BRivsC/ELO301-G8/Diseño/Cotización PCB.xlsx

Características impresión
Tamaño | 82,50x70,00 mm
# de capas | 2
Sin ensamblado
Fabricante | Por 100 Us | Por 1 Un | Transporte | Empresa transporte | Tiempo de envío | Total
PCBWay | $91.02 | $0.9102 | $79.61 | FedEx IP | 4-7 días hábiles | $170.63
JLCPCB | $34.80 | $0.3480 | $88.95 | DHL Express Economy | 5-7 días hábiles | $123.75
NextPCB | $58.92 | $0.5892 | $80.32 | FedEx | 3-5 días hábiles | $139.24
