BRivsC/ELO301-G8/WIFI_Shield_Rev4/WIFI_Shield_Rev4/SCHEMATIC_R1.brd

## EAGLE design WIFI_Shield_Rev4/WIFI_Shield_Rev4/SCHEMATIC_R1.brd (2023-12-03)

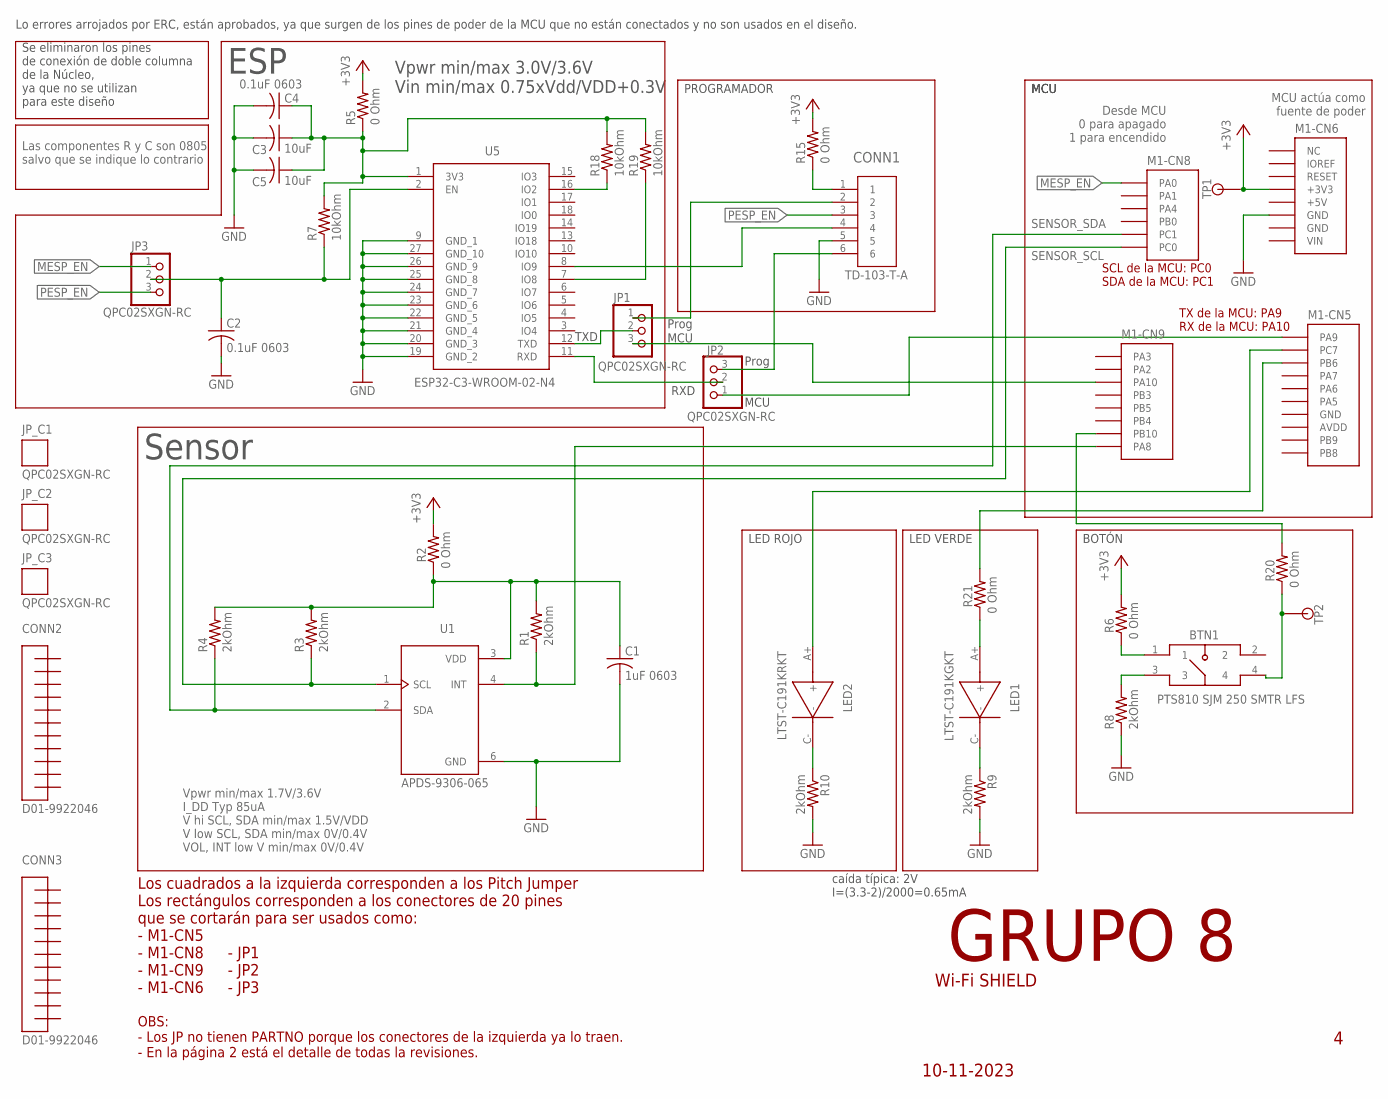
[picture p4: schematic SCHEMATIC_R1.sch, sheet 1]

Parts:
BTN1: PTS810 SJM 250 SMTR LFS; PTS810; PARTNO PTS810 SJM 250 SMTR LFS
C1: 1uF 0603; C0603; PARTNO GCM188R71C105KA64D
C2, C4: 0.1uF 0603; C0603; PARTNO GRM188R72A104KA35D
C3, C5: 10uF; C0805; PARTNO GRM21BR71A106KA73L
CONN1: TD-103-T-A; CON6_2X3_TU_HTS_SAI; PARTNO TD-103-T-A
JP1, JP2, JP3: QPC02SXGN-RC; 1X03
JP_C1, JP_C2, JP_C3: QPC02SXGN-RC; PLACEHOLDER; PARTNO QPC02SXGN-RC
LED1: LTST-C191KGKT; 0603; PARTNO LTST-C191KGKT
LED2: LTST-C191KRKT; 0603; PARTNO LTST-C191KRKT
M1: NUCLEO-L452RE; NUCLEO-64; PARTNO NUCLEO-L452RE
R1, R3, R4, R8, R9, R10: 2kOhm; M0805; PARTNO RMCF0805FT2K00
R2, R5, R6, R15, R20, R21: 0 Ohm; M0805; PARTNO RMCF0805ZT0R00
R7, R18, R19: 10kOhm; R0805; PARTNO RMCF0805JT10K0
TP1, TP2: TESTPOINT
U1: APDS-9306-065; SON65P200X200X75-6N; PARTNO APDS-9306-065
U5: ESP32-C3-WROOM-02-N4; ESP32C3WROOM02N4; PARTNO ESP32-C3-WROOM-02-N4

Connections:
+3V3: M1.CN6-4 (+3V3), R2.2, R5.2, R6.2, R15.2, TP1.TP
+5V: M1.CN6-5 (+5V)
AVDD: M1.CN5-8 (AVDD)
GND: C1.2, C2.2, C3.2, C4.2, C5.2, CONN1.5, M1.CN5-7 (GND), M1.CN6-6 (GND), M1.CN6-7 (GND), R8.1, R9.2, R10.2, U1.6 (GND), U5.9 (GND_1), U5.19 (GND_2), U5.20 (GND_3), U5.21 (GND_4), U5.22 (GND_5), U5.23 (GND_6), U5.24 (GND_7), U5.25 (GND_8), U5.26 (GND_9), U5.27 (GND_10)
IOREF: M1.CN6-2 (IOREF)
MESP_EN: JP3.1, M1.CN8-1 (PA0)
unnamed: M1.CN9-7 (PB10), R20.2
unnamed: C1.1, R1.2, R2.1, R3.2, R4.2, U1.3 (VDD)
unnamed: M1.CN9-8 (PA8), R1.1, U1.4 (INT)
unnamed: LED2.A+ (+), M1.CN5-2 (PC7)
unnamed: BTN1.3, R8.2
unnamed: R18.1, U5.16 (IO2)
unnamed: BTN1.1, R6.1
unnamed: JP1.3, M1.CN9-3 (PA10)
unnamed: JP2.1, M1.CN5-1 (PA9)
unnamed: BTN1.4, R20.1, TP2.TP
unnamed: M1.CN5-3 (PB6), R21.2
unnamed: LED2.C- (-), R10.1
unnamed: LED1.C- (-), R9.1
unnamed: JP2.2, U5.11 (RXD)
unnamed: CONN1.2, JP1.1
unnamed: CONN1.6, JP2.3
unnamed: CONN1.4, U5.8 (IO9)
unnamed: CONN1.1, R15.1
unnamed: R19.1, U5.7 (IO8)
unnamed: C2.1, JP3.2, R7.1, U5.2 (EN)
unnamed: C3.1, C4.1, C5.1, R5.1, R7.2, R18.2, R19.2, U5.1 (3V3)
unnamed: LED1.A+ (+), R21.1
unnamed: JP1.2, U5.12 (TXD)
PESP_EN: CONN1.3, JP3.3
SENSOR_SCL: M1.CN8-6 (PC0), R3.1, U1.1 (SCL)
SENSOR_SDA: M1.CN8-5 (PC1), R4.1, U1.2 (SDA)
VIN: M1.CN6-8 (VIN)

Notes on the sheet:
Vpwr min/max 3.0V/3.6V Vin min/max 0.75xVdd/VDD+0.3V
Vpwr min/max 1.7V/3.6V I_DD Typ 85uA V hi SCL, SDA min/max 1.5V/VDD V low SCL, SDA min/max 0V/0.4V VOL, INT low V min/max 0V/0.4V
Las componentes R y C son 0805 salvo que se indique lo contrario
Desde MCU 0 para apagado 1 para encendido
caída típica: 2V I=(3.3-2)/2000=0.65mA
Se eliminaron los pines de conexión de doble columna de la Núcleo, ya que no se utilizan para este diseño
Sensor
LED ROJO
LED VERDE
BOTÓN
MCU
PROGRAMADOR
ESP
MCU actúa como fuente de poder
Lo errores arrojados por ERC, están aprobados, ya que surgen de los pines de poder de la MCU que no están conectados y no son usados en el diseño.
Wi-Fi SHIELD
10-11-2023
GRUPO 8
RXD
Prog
TXD
Los cuadrados a la izquierda corresponden a los Pitch Jumper Los rectángulos corresponden a los conectores de 20 pines que se cortarán para ser usados como: - M1-CN5 - M1-CN8 - M1-CN9 - M1-CN6
OBS: - Los JP no tienen PARTNO porque los conectores de la izquierda ya lo traen. - En la página 2 está el detalle de todas la revisiones.
- JP1 - JP2 - JP3
TX de la MCU: PA9 RX de la MCU: PA10
SCL de la MCU: PC0 SDA de la MCU: PC1

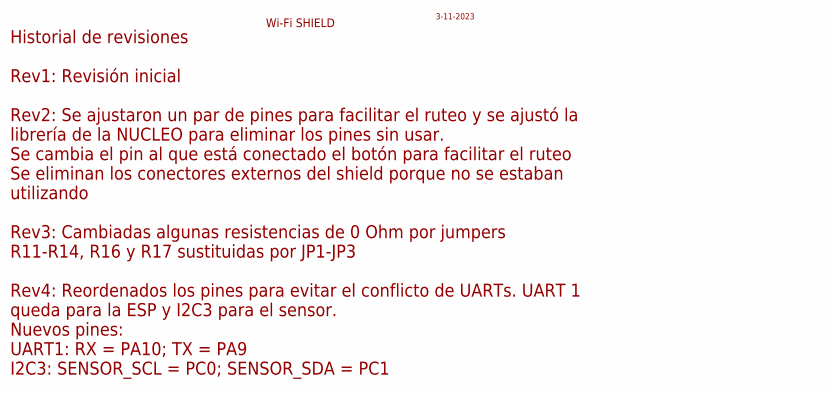
[picture p5: schematic SCHEMATIC_R1.sch, sheet 2]

Notes on the sheet:
Wi-Fi SHIELD
3-11-2023
Historial de revisiones Rev1: Revisión inicial Rev2: Se ajustaron un par de pines para facilitar el ruteo y se ajustó la librería de la NUCLEO para eliminar los pines sin usar. Se cambia el pin al que está conectado el botón para facilitar el ruteo Se eliminan los conectores externos del shield por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

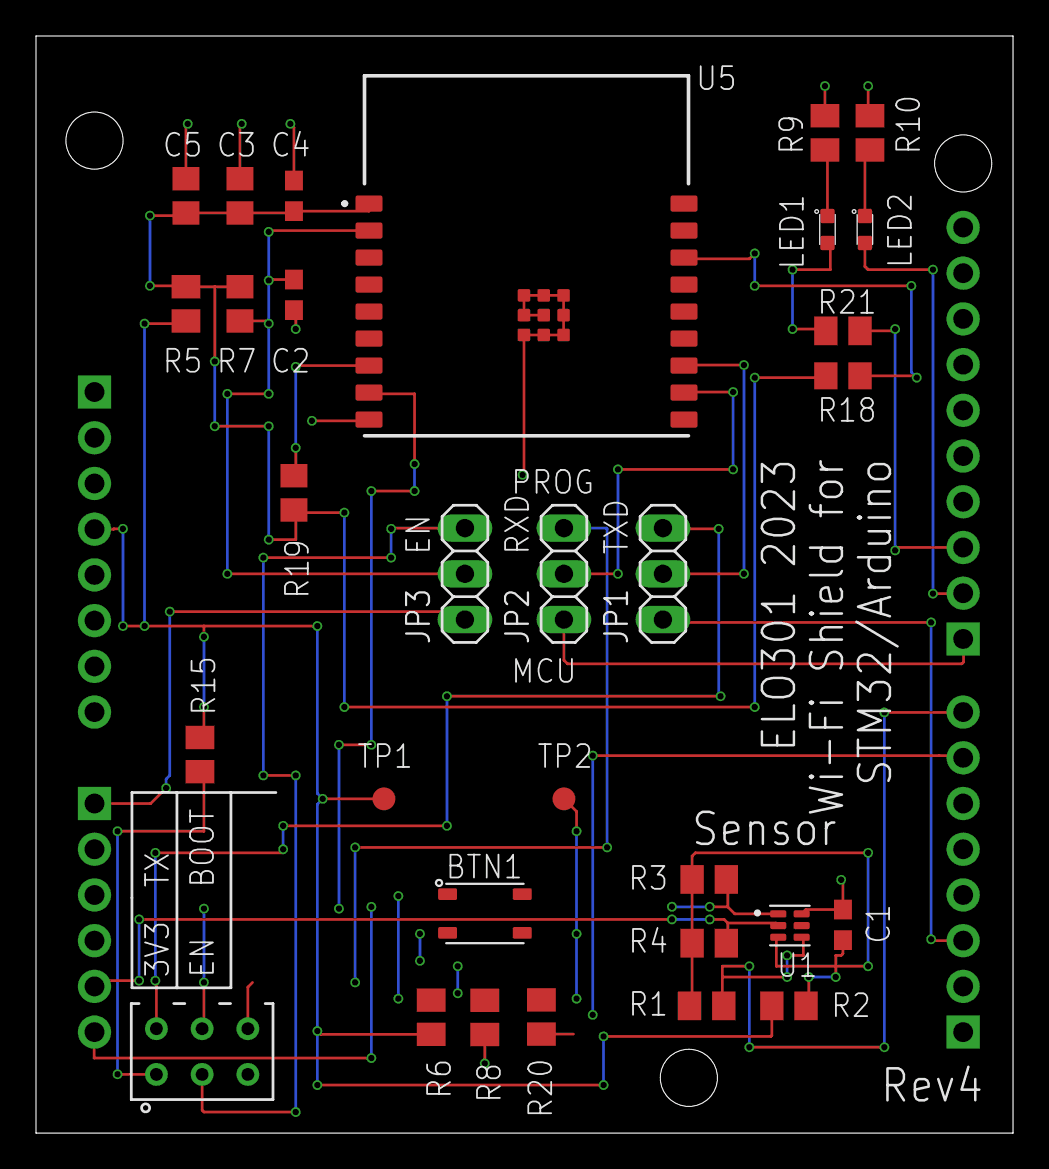
[picture p6: board SCHEMATIC_R1.brd from above]

Board: 2 copper layers, 54.3 x 60.9 mm, 35 parts (0 on the bottom side), 29 nets.
