BRivsC/ELO301-G8/Firmware/FW Wi-Fi Shield Rev1/Core/Src/main.c

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
/* Includes ------------------------------------------------------------------*/
#include "main.h"
#include "i2c.h"
#include "tim.h"
#include "usart.h"
#include "gpio.h"

/* USER CODE BEGIN Includes */
#include "interrupts.h"
#include "at_command.h"
#include "GebraBit_APDS9306.h"
/* USER CODE END Includes */

/* USER CODE BEGIN PTD */
GebraBit_APDS9306 APDS9306_Module;	// struct con los datos del sensor
/* USER CODE END PTD */

/* USER CODE BEGIN PM */
// Mensaje de bienvenida
#define WELCOME_MSG	"ELO301 Wi-Fi Shield\n\rRevisión actual: Rev1\n\r"

#define SENSOR_TEST_EN 0			// Macro para el test del sensor. 1 para testearlo, 0 para el funcionamiento normal
#define SENSOR_TEST_WELCOME_MSG "Modo de prueba del sensor.\n\rPara salir, definir SENSOR_TEST_EN de main.c en 0 y recompilar\n\r"
#define MSG_SIZE 30					// Tamaño del mensaje a enviar por la UART2
#define SENSOR_TEST_DELAY_MS 250	// Delay para mediciones del test
#define TIMEOUT_100MS 100

#define SEND_CLK 0					// 1 para mandar valor del clock en lugar de la medición del sensor
#define CON_TEST 0					// 1 para probar conexión
/* USER CODE END PM */


/* USER CODE BEGIN PV */
enum ESTADO estado=WAIT_ESP;		//Variable que identifica el estado del sistema (FSM).
int BTN=0;							//1 si se resionó el botón, 0 eoc.
enum ESP_ESTADO esp_connect=WAIT;	//resultado de la conexión a internet de la ESP.
enum ESP_ESTADO esp_envio=WAIT; 	//resultado del envío de datos.
volatile char msg;
int disc=0;
int ESP_OK=0;
int ESP_READY=0;
int count=0;
//int timeout=1;
int NI=1;
enum LEDS leds=OFF;					//estado de los leds de estado.
int Q_OK=0;
extern uint8_t rx_buffer;
float luminosidad;					// luminosidad medida
int luminosidad_int;				// luminosidad en entero
/* USER CODE END PV */

void SystemClock_Config(void);
/**
  * @brief  The application entry point.
  * @retval int
  */
int main(void)
{
  /* USER CODE BEGIN 1 */
	//enum ESTADO estado=WAIT_ESP;		//Variable que identifica el estado del sistema (FSM).
	int intentos=0;						//Contador de intentos de conexión.

	uint32_t timeout=0;
	uint32_t DELAY = 2000;
							//1 para ESP lista para trabajar, 0 eoc.
	//int BTN=0;							//1 si se resionó el botón, 0 eoc.
	int reconexion=0;					//1 si se intenta reconexión, 0 eoc.
	chg_led_state(leds);				//al iniciar el sistema se apagan los leds (estado de WAIT_ESP)
	uint32_t time;
	uint8_t text[10];
	memset(text,"\0",10);
	/* USER CODE END 1 */

  /* MCU Configuration--------------------------------------------------------*/

  /* Reset of all peripherals, Initializes the Flash interface and the Systick. */
  HAL_Init();

  /* USER CODE BEGIN Init */
  // Conectarse a ESP


  /* USER CODE END Init */

  /* Configure the system clock */
  SystemClock_Config();

  /* Initialize all configured peripherals */
  MX_GPIO_Init();
  MX_USART2_UART_Init();
  MX_I2C3_Init();
  MX_TIM3_Init();
  MX_USART1_UART_Init();
  /* USER CODE BEGIN 2 */

  char medicion_uart[MSG_SIZE];	// mensaje a mandar por UART
  GB_APDS9306_initialize(&APDS9306_Module);
  GB_APDS9306_Configuration(&APDS9306_Module);

#if SENSOR_TEST_EN
  /* Test del sensor:
   * 	- Leer ID del sensor y printear su ID
   * 	- Tomar mediciones cada cierto tiempo definido por SENSOR_TEST_DELAY_MS y enviarlas por la UART2 como texto
   */
  //char msg[MSG_SIZE];	// mensaje a mandar por UART
  //float luminosidad;	// la variable que extrae la medición de luminosidad
  //int luminosidad_int;	// luminosidad como entero para poder usar sprintf sin reconfigurar el proyecto
  /* Inicializar struct del sensor
   * 	De esto interesa conseguir al miembro PART_ID del struct para identificar el sensor
   */
  GB_APDS9306_initialize(&APDS9306_Module);
  GB_APDS9306_Configuration(&APDS9306_Module);


  // Mensaje de bienvenida
  HAL_UART_Transmit(&huart2, (uint8_t*) SENSOR_TEST_WELCOME_MSG, strlen(SENSOR_TEST_WELCOME_MSG),TIMEOUT_100MS);

  // Obtener ID del sensor y mandarla por UART
  sprintf(msg, "ID: %02X\n\r",APDS9306_Module.PART_ID);
  HAL_UART_Transmit(&huart2, (uint8_t*) msg, strlen(msg), TIMEOUT_100MS);

  /* Loop infinito: Tomar mediciones cada 1 segundo permanentemente
   * 	Cada medición tomada se registra en el miembro LUMINOSITY del struct APDS9306_Module
   * 	Ojo! Mide en float, por lo que puede que sprintf tire error si no se reconfigura el proyecto
   */

  while(1){
	  // Obtener medición
	  GB_APDS9306_Get_Data(&APDS9306_Module);

	  // Cast como INT para evitar reconfigurar MCU porque sprintf tiene mañas con los float
	  luminosidad = APDS9306_Module.LUMINOSITY;	// rescatar luminosidad del struct
      luminosidad_int = (int) luminosidad;


      // Generar mensaje y enviarlo por UART2
      sprintf(msg, ">>Medición: %d\n\r",luminosidad_int);	// Va desde 0 (oscuro) a 873810 (luz solar directa)
      HAL_UART_Transmit_IT(&huart2, (uint8_t*) msg, strlen(msg));
      HAL_Delay(SENSOR_TEST_DELAY_MS);

  }
#endif

  HAL_UART_Transmit(&huart2, (uint8_t*) WELCOME_MSG, strlen(WELCOME_MSG),TIMEOUT_100MS);
  /* USER CODE END 2 */

  /* Infinite loop */
  /* USER CODE BEGIN WHILE */
  HAL_UART_Receive_IT(&huart1, (uint8_t*) &msg, 1);
  resetModule();
  //HAL_UART_Transmit_IT(&huart1, "ATE0\r\n", 6);
  while (1){
	  switch(estado){
	  	  case WAIT_ESP:
	  		//HAL_UART_Transmit(&huart2, "HOLA\r\n", 6, 100);
	  		  if(ESP_OK){
		  		  reconexion=0;
	  			  intentos=0;
	  			  esp_connect=FAIL;

#if CON_TEST
	  			  HAL_UART_Transmit_IT(&huart1, "AT+CWQAP\r\n", 10);
	  			  estado=QUERY_CONEXION;
#else
	  			  setModeToStation();
	  			  HAL_UART_Transmit(&huart2, rx_buffer, sizeof(rx_buffer), TIMEOUT_100MS);
	  			  estado=WAIT_OK_ESP;
	  			  ESP_READY=0;
#endif
	  			  ESP_OK=0;
	  		  }
	  		  else{
	  			  estado=WAIT_ESP;
	  		  }
			  break;
	  	  case QUERY_CONEXION:
	  		  if(Q_OK){
	  			  setModeToStation();
	  			  HAL_UART_Transmit(&huart2, rx_buffer, sizeof(rx_buffer), TIMEOUT_100MS);
	  			  estado=WAIT_OK_ESP;
	  			  Q_OK=0;
	  		  }
	  		  else{
	  			  estado=QUERY_CONEXION;
	  		  }
	  		  ESP_READY=0;
	  		  break;
	  	  case WAIT_OK_ESP:
  			  if(ESP_READY==1){
  				HAL_UART_Transmit(&huart2, rx_buffer, sizeof(rx_buffer), TIMEOUT_100MS);
  				estado=ESTABLECER_CONEXION_WI_FI;
  				ESP_READY=0;
  			  }
  			  else{
  				  estado=WAIT_OK_ESP;
  			  }
  			  break;
	  	  case ESTABLECER_CONEXION_WI_FI:
	  		  estado=ESTABLECER_CONEXION_WI_FI;
	  		  if((intentos<3)&&(esp_connect==FAIL)){		//3 intentos para establecer conexión
	  			  //mandar comando AT para conexión
	  			  setAPcnx();
	  			  intentos+=1;
	  			  if (intentos != 3){
	  				  esp_connect=WAIT;
	  				  estado=ESTABLECER_CONEXION_WI_FI;
	  			  }
	  			  else{
	  				  estado=ESTABLECER_CONEXION_WI_FI;
	  			  }
	  		  }
	  		  else if((esp_connect==OK)&&(reconexion==0)){	//Correcta conexión por primera vez
	  		  	  leds=CONEXION_EXITOSA;
	  			  chg_led_state(leds);
	  			  estado=CONECTADO;
	  		  }
	  		  else if((esp_connect==OK)&&(reconexion==1)){	//Reconexión para volver a intentar el envío de datos
	  			  leds=BUSY;
	  			  chg_led_state(leds);
	  			  esp_envio=WAIT;
	  			  estado=ENVIAR_DATOS;
	  		  }
	  		  else if((esp_connect==FAIL)&&(intentos==3)){	//Falla la conexión, se reinicia la ESP
	  			  ESP_OK=0;
	  			  leds=FALLO_CRITICO;
	  			  chg_led_state(leds);
	  			  timeout=HAL_GetTick();
	  			  estado=FALLO_CONEXION;
	  		  }
	  		  else{
	  			  estado=ESTABLECER_CONEXION_WI_FI;
	  		  }
	  		  break;
	  	  case CONECTADO:
	  		  if(BTN && disc==0){//Hay que recolectar y enviar datos
	  			  leds=BUSY;
	  			  chg_led_state(leds);
	  			  //lee sensor
	  			  GB_APDS9306_Get_Data(&APDS9306_Module);

	  			  esp_envio=WAIT;
	  			  BTN=0;
	  			  estado=ENVIAR_DATOS;
	  		  }
	  		  else if(disc==1){
	  			  disc=0;
	  			  estado=ESTABLECER_CONEXION_WI_FI;
	  		  }
	  		  else{
	  			  estado=CONECTADO;
	  		  }
	  		  break;
	  	  case ENVIAR_DATOS:
#if SEND_CLK
	  		  // Mandar valor actual del CLK
	  		  time=HAL_GetTick();
	  		  memset(text,"\0",10);
	  		  sprintf(text,"%d",time);
	  		  sendSensorData((uint8_t*)text);

#else
	  		  // Mandar medición del sensor
	  		  // Cast como INT para evitar reconfigurar MCU porque sprintf tiene mañas con los float
	  		  luminosidad = APDS9306_Module.LUMINOSITY;	// rescatar luminosidad del struct
	  	      luminosidad_int = (int) luminosidad;
	  	      sprintf(text,"%d",luminosidad_int);
	  	      sprintf(medicion_uart, ">>Medición: %d\n\r",luminosidad_int);	// Va desde 0 (oscuro) a 873810 (luz solar directa)
	  	      HAL_UART_Transmit_IT(&huart2, (uint8_t*) medicion_uart, strlen(medicion_uart));
	  		  sendSensorData((uint8_t*)text);
#endif
	  		  estado=WAIT_ENVIAR_DATOS;
	  		  break;
	  	  case WAIT_ENVIAR_DATOS:
	  		  if(esp_envio==OK){//se enviaron correctamente los datos
	  			  leds=CONEXION_EXITOSA;
	  			  chg_led_state(leds);
	  			  estado=CONECTADO;
	  		  }
	  		  else if(esp_envio==FAIL){//Fallo al enviar datos
	  			  timeout=HAL_GetTick();
	  			  estado=PERDIO_CONEXION;
	  		  }
	  		  else{
	  			  estado=WAIT_ENVIAR_DATOS;
	  		  }
	  		  break;
	  	  case PERDIO_CONEXION:
			leds=FALLO_CRITICO;
	  		chg_led_state(leds);
	  		reconexion=1;
	  		esp_connect=FAIL; //CAMBIADO A FAIL, PARA QUE INTENTE CONETARSE
	  		intentos=0;
	  		if((timeout+DELAY) <= HAL_GetTick()){
	  			leds=OFF;
	  			timeout=0;
	  			chg_led_state(leds);
	  			estado=ESTABLECER_CONEXION_WI_FI;
	  		}
	  		else{
	  			estado=PERDIO_CONEXION;
	  		}
	  		break;
	  	  case FALLO_CONEXION:
	  		if((timeout+DELAY) <= HAL_GetTick()){
	  			resetModule();
	  			leds=OFF;
	  			timeout=0;
	  			ESP_OK=0;
	  			chg_led_state(leds);
	  			estado=WAIT_ESP;
	  		}
	  		else{
	  			estado=FALLO_CONEXION;
	  		}
	  		break;
			

	  };
    /* USER CODE END WHILE */

    /* USER CODE BEGIN 3 */
  }
  /* USER CODE END 3 */
}

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
