BRivsC/ELO301-G8/Firmware/FW Wi-Fi Shield Rev1/FW Wi-Fi Shield Rev1.ioc

Mcu.UserName=STM32L452RETx
PA0.GPIO_Label=MESP_EN
PA0.Signal=GPIO_Output
PA10.GPIO_Label=RX_STM
PA10.Signal=USART1_RX
PA2.Signal=USART2_TX
PA3.Signal=USART2_RX
PA5.GPIO_Label=LD4 [green Led]
PA5.Signal=GPIO_Output
PA8.GPIO_Label=SENSOR_INT
PA8.Signal=GPXTI8
PA9.GPIO_Label=TX_STM
PA9.Signal=USART1_TX
PB10.GPIO_Label=GPIO_BOTON
PB10.Signal=GPXTI10
PB6.GPIO_Label=GPIO_LED_ROJO
PB6.Signal=GPIO_Output
PC0.GPIO_Label=SENSOR_SCL
PC0.Signal=I2C3_SCL
PC1.GPIO_Label=SENSOR_SDA
PC1.Signal=I2C3_SDA
PC13.GPIO_Label=B1 [Blue PushButton]
PC13.Signal=GPXTI13
PC7.GPIO_Label=GPIO_LED_VERDE
PC7.Signal=GPIO_Output
