BRivsC/ELO301-G8/Firmware/FW Wi-Fi Shield Rev1/Core/Inc/main.h

#define B1_Pin GPIO_PIN_13
#define B1_GPIO_Port GPIOC
#define B1_EXTI_IRQn EXTI15_10_IRQn
#define SENSOR_SCL_Pin GPIO_PIN_0
#define SENSOR_SCL_GPIO_Port GPIOC
#define SENSOR_SDA_Pin GPIO_PIN_1
#define SENSOR_SDA_GPIO_Port GPIOC
#define MESP_EN_Pin GPIO_PIN_0
#define MESP_EN_GPIO_Port GPIOA
#define LD4_Pin GPIO_PIN_5
#define LD4_GPIO_Port GPIOA
#define GPIO_BOTON_Pin GPIO_PIN_10
#define GPIO_BOTON_GPIO_Port GPIOB
#define GPIO_BOTON_EXTI_IRQn EXTI15_10_IRQn
#define GPIO_LED_VERDE_Pin GPIO_PIN_7
#define GPIO_LED_VERDE_GPIO_Port GPIOC
#define SENSOR_INT_Pin GPIO_PIN_8
#define SENSOR_INT_GPIO_Port GPIOA
#define TX_STM_Pin GPIO_PIN_9
#define TX_STM_GPIO_Port GPIOA
#define RX_STM_Pin GPIO_PIN_10
#define RX_STM_GPIO_Port GPIOA
#define TMS_Pin GPIO_PIN_13
#define TMS_GPIO_Port GPIOA
#define TCK_Pin GPIO_PIN_14
#define TCK_GPIO_Port GPIOA
#define SWO_Pin GPIO_PIN_3
#define SWO_GPIO_Port GPIOB
#define GPIO_LED_ROJO_Pin GPIO_PIN_6
#define GPIO_LED_ROJO_GPIO_Port GPIOB
