BRivsC/ELO301-G8/Firmware/FW Wi-Fi Shield Rev1/Core/Inc/interrupts.h

/*
 * interrupts.h
 *
 *  Created on: Nov 7, 2023
 *      Author: Basti
 */

#ifndef INC_INTERRUPTS_H_
#define INC_INTERRUPTS_H_
#include "main.h"

void HAL_GPIO_EXTI_Callback(uint16_t GPIO_Pin);

#endif /* INC_INTERRUPTS_H_ */
