BRivsC/ELO301-G8/(commit log)

2023-10-19 Eliminadas versiones previas del esquemático
    [BOM_v4.csv, SCHEMATIC_R1.sch]
2023-10-19 Agregada la segunda revisión del doc de diseño
2023-10-19 Agregada la ruta al .sch del esquemático
2023-10-23 Se modifica disposicion de componentes en la placa
    [SCHEMATIC_R1.brd]
2023-10-29 Se sube revison 2. En esta revisoón se cambia el pin del booón y se modifica un poco la libreria del shield nucleo
    [SCHEMATIC_R1.brd, SCHEMATIC_R1.sch]
2023-10-30 Corregidos algunos wire stubs. Cambiado IO9 por BOOT en Silkscreen
2023-10-30 Añadida información al README y versiones antiguas
    [BOM_Wi-Fi_SHIELD.csv, SCHEMATIC_R1.brd, SCHEMATIC_R1.sch]
2023-10-30 Agregado el BOM correspondiente
    [BOM_Wi-Fi_SHIELD.csv]
2023-10-30 Agregados BOM y archivos de manufactura
    [BOM_Wi-Fi_SHIELD_Rev2.csv]
2023-10-30 Eliminado el BOM fallido
    [BOM_Wi-Fi_SHIELD.csv]
2023-11-02 Agregada Rev3. Leer README para más información
    [BOM_Wi-Fi_SHIELD_Rev3.csv, SCHEMATIC_R1.brd, SCHEMATIC_R1.sch]
2023-11-03 Arreglados los jumpers que no aparecían en el BOM. Agregados comentarios adicionales
    [BOM_Wi-Fi_SHIELD_Rev3.csv, SCHEMATIC_R1.brd, SCHEMATIC_R1.sch]
2023-11-10 Agregada la base del firmware
2023-11-10 Revisión 4: Cambiado el UART y el I2C
    [BOM_Wi-Fi_SHIELD_Rev4.csv, SCHEMATIC_R1.brd, SCHEMATIC_R1.sch]
2023-11-13 Actualizado el .ioc para remapear los pines a lo del HW Rev4
2023-11-17 Se agrega FW con ma´quina de estados implementada. Falta agregar estados para que funcionen comandos at
2023-11-28 Arreglada la máquina de estados y agregado el test del sensor
    [FW Wi-Fi Shield Rev1.ioc, GebraBit_APDS9306.c, GebraBit_APDS9306.h, at_command.h, defines.h]
2023-12-01 Correcciones menores en el test del sensor
2023-12-01 Actualizado para enviar el valor del clock a ThingSpeak
2023-12-03 Arreglos menores en el test del sensor
    [SCHEMATIC_R1.brd]
