BRivsC/ELO301-G8/(notices)

Notices in the files:
Firmware/FW Wi-Fi Shield Rev1/Core/Inc/main.h:
Copyright (c) 2023 STMicroelectronics.
All rights reserved.
This software is licensed under terms that can be found in the LICENSE file
parts and their libraries:
COPYRIGHT: Copyright (C) 2023 Ultra Librarian. All rights reserved.
